ararobo/HTMDv2.2s/simpleBOM.xlsx

HTMDv2.2sBOM |  |  | 27623 |  |  | 単価(購入済み除く) | 2908.3
部品名 | 型番(定数) | 個数 |  | 単価 | 小計 | リンク | データシート | 1枚必要数 | 単価計算用
スイッチングレギュレータ | TPS628511DRLR | 10 | 個 | 177.5 | 1775 | TPS628511DRLR Texas Instruments | Mouser 日本 (https://www.mouser.jp/ProductDetail/Texas-Instruments/TPS628511DRLR?qs=QNEnbhJQKvbbsogrZa0o0A%3D%3D) | TPS62851x 2.7V～6V、0.5A/1A/2A/3A 降圧コンバータ、SOT583 パッケージ datasheet (Rev. B) (ti.com) (https://www.ti.com/jp/lit/ds/symlink/tps628511.pdf?ts=1696764551116) | 1 | 177.5
チップインダクタ | 0.47uH | 1 | パック(4個) | 100 | 100 | チップインダクター ０．４７μＨ３．３Ａ （４個入）: パーツ一般 秋月電子通商-電子部品・ネット通販 (akizukidenshi.com) (https://akizukidenshi.com/catalog/g/gP-15627/) |  | 1 | 25
抵抗 | 88.7k | 100 | 個 | 2 | 200 | CRCW060388K7FKEAC Vishay / Dale | Mouser 日本 (https://www.mouser.jp/ProductDetail/Vishay-Dale/CRCW060388K7FKEAC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) |  | 1
抵抗 | 19.6k | 100 | 個 | 1.4 | 140 | CRCW060319K6FKEAC Vishay / Dale | Mouser 日本 (https://www.mouser.jp/ProductDetail/Vishay-Dale/CRCW060319K6FKEAC) |  | 1
コンデンサ | 10p | 1000 | 個 | 1.8 | 1800 | KGM15ACG1H100JT KYOCERA AVX | Mouser 日本 (https://www.mouser.jp/ProductDetail/KYOCERA-AVX/KGM15ACG1H100JT) |  | 6
STM32G431CBU6 |  | 10 | 個 | 892 | 8920 | STM32G431CBU6 STMicroelectronics | Mouser 日本 (https://www.mouser.jp/ProductDetail/STMicroelectronics/STM32G431CBU6?qs=T3oQrply3y%252B0hTuSHQ7oqA%3D%3D) |  |  | 892
温度センサ | TMP275AQDGKRQ1 | 10 | 個 | 264 | 2640 | TMP275AQDGKRQ1 Texas Instruments | Mouser 日本 (https://www.mouser.jp/ProductDetail/Texas-Instruments/TMP275AQDGKRQ1?qs=8%2FmU9qzJpL%2FVpQiyN9hSdg%3D%3D) |  |  | 264
デジタルアイソレータ | ISO6741FDWR | 10 | 個 | 370.3 | 3703 | ISO6741FDWR Texas Instruments | Mouser 日本 (https://www.mouser.jp/ProductDetail/Texas-Instruments/ISO6741FDWR?qs=eP2BKZSCXI7%252BuWOGH5QbwQ%3D%3D) |  |  | 370.3
電流センサ | CZ3A05 | 10 | 個 | 789.5 | 7895 | https://www.mouser.jp/ProductDetail/Asahi-Kasei-Microdevices/CZ3A05?qs=vvQtp7zwQdOg3bf1lH9vOg%3D%3D |  |  | 789.5
精密抵抗 | 1kohm | 1 | パック(5個) | 100 | 100 | 超精密級 金属皮膜チップ抵抗器 １６０８ １／１０Ｗ１ｋΩ ±０．１％ （５個入）: パーツ一般 秋月電子通商-電子部品・ネット通販 (akizukidenshi.com) (https://akizukidenshi.com/catalog/g/gR-11790/) |  |  | 40
ADC | MCP3421A0T-E/CH | 1 | 個 | 350 | 350 | https://akizukidenshi.com/catalog/g/gI-16585/ |  |  | 350
 |  |  |  |  | 0
 |  |  |  |  | 0
 |  |  |  |  | 0
 |  |  |  |  | 0
 |  |  |  |  | 0
 |  |  |  |  | 0
 |  |  |  |  | 0
 |  |  |  |  | 0
 |  |  |  |  | 0
 |  |  |  |  | 0
