ararobo/HTMDv2.2s/HTMDv2.2s.kicad_pcb

## KiCad design HTMDv2.2s.kicad_pcb (2023-12-18)

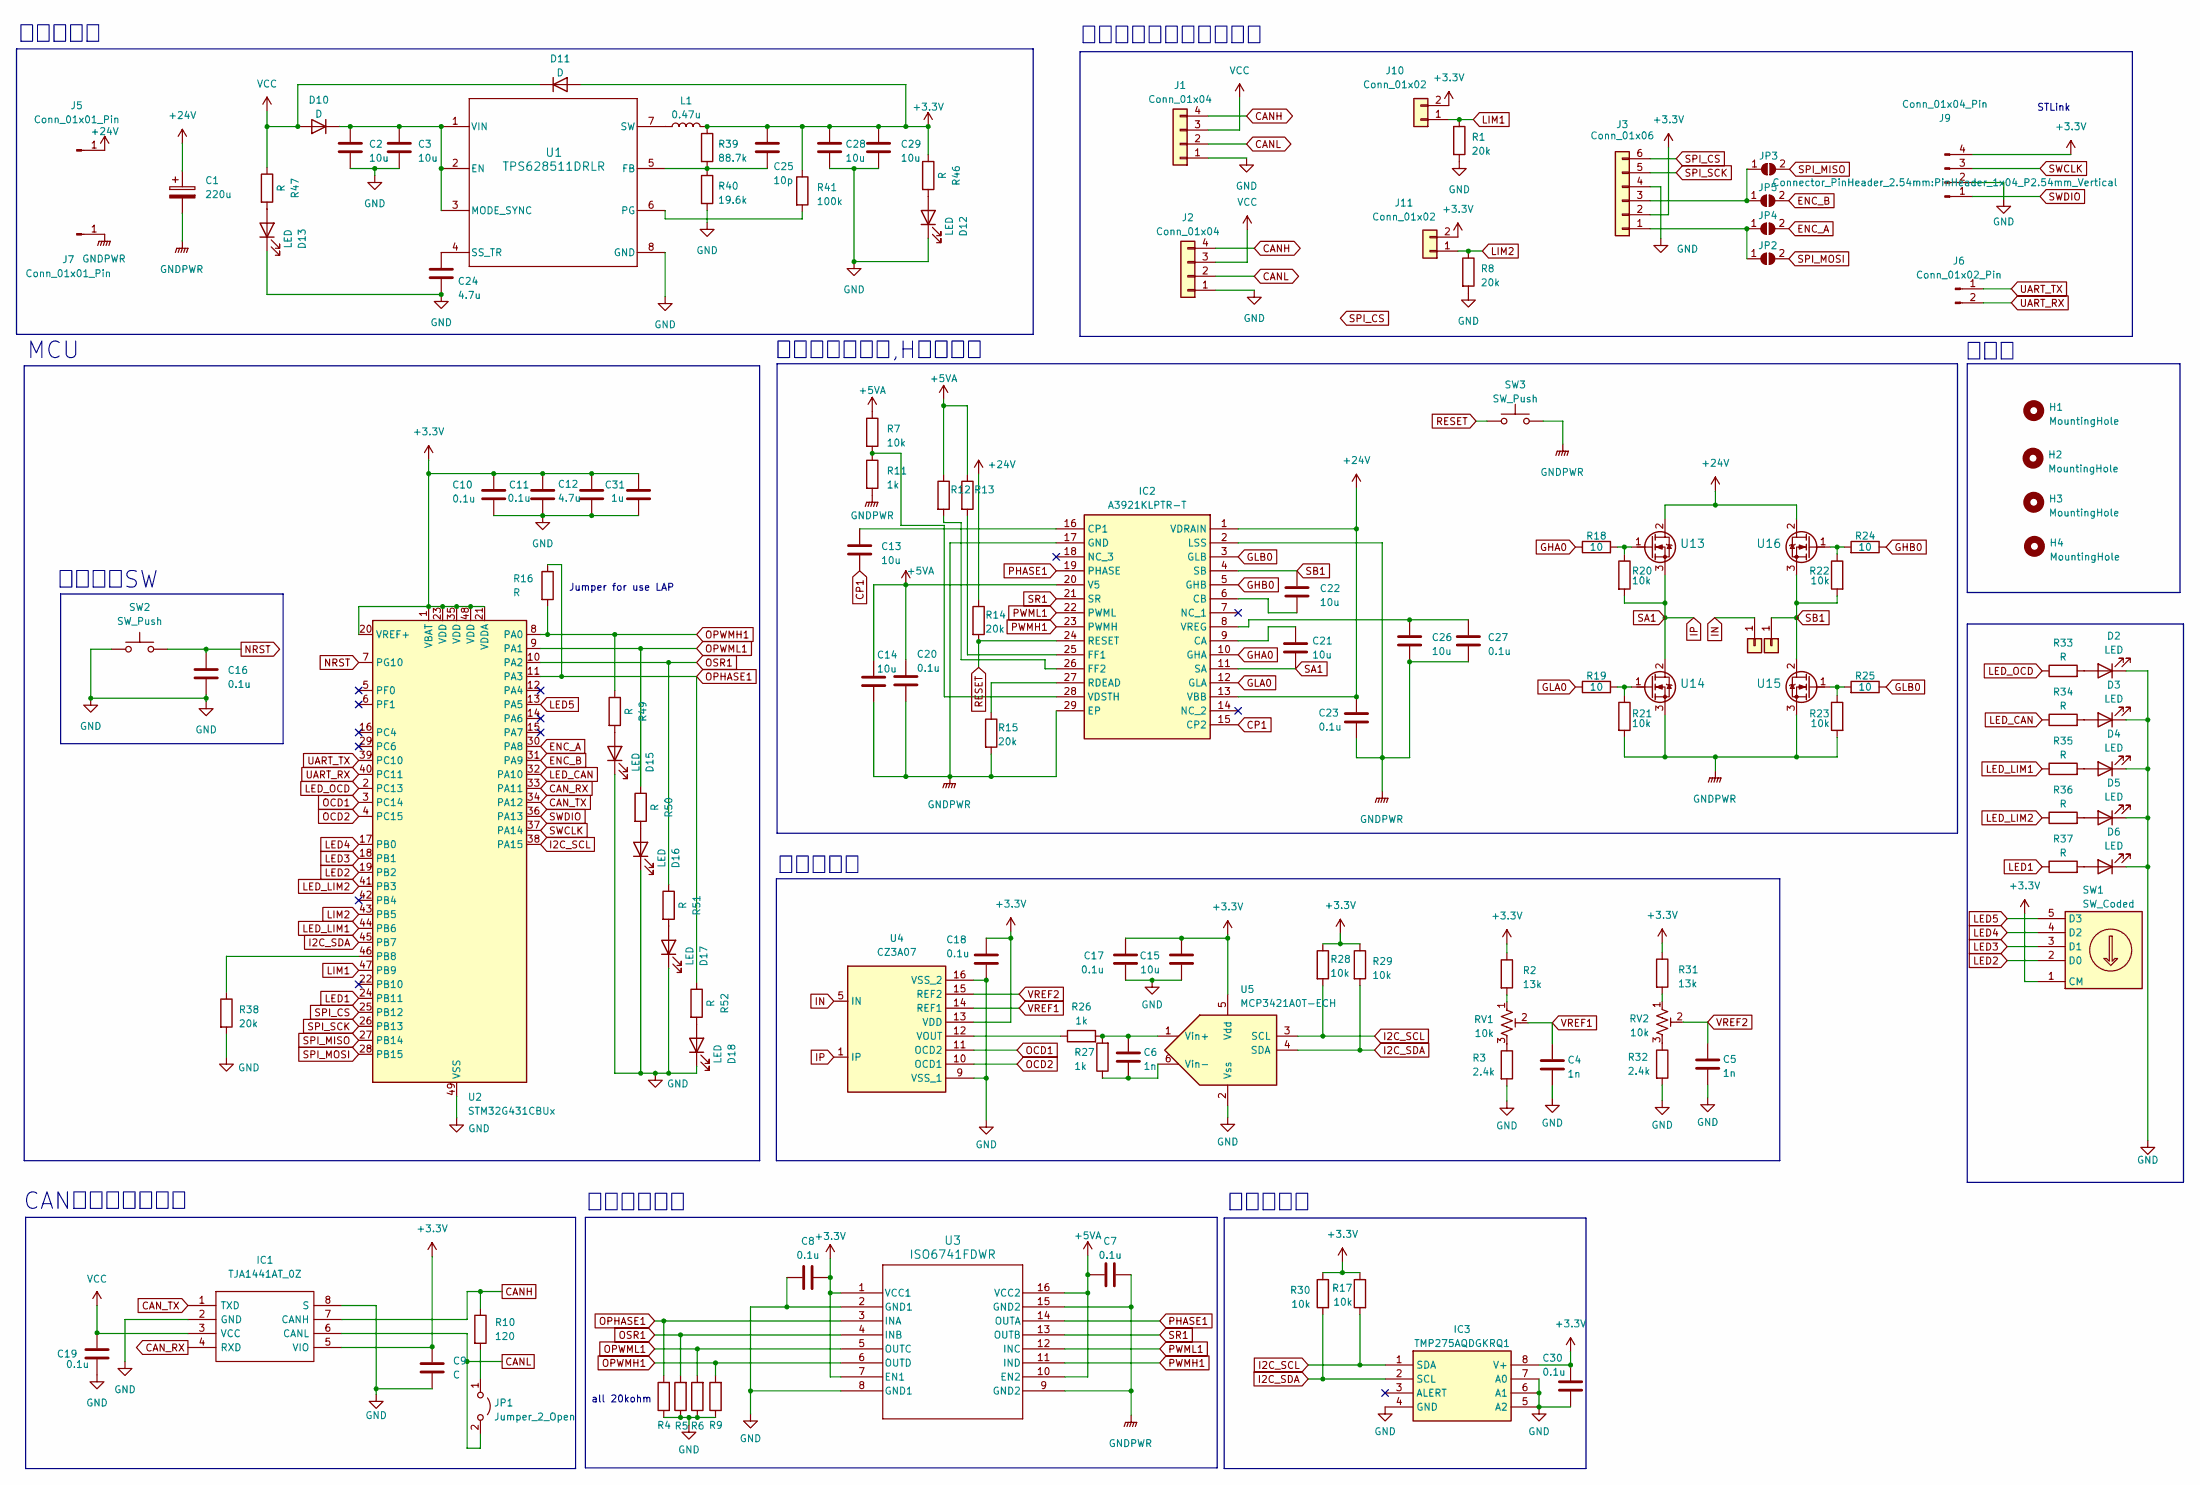
[picture p1: schematic HTMDv2.2s.kicad_sch]

Parts:
C1: 220u; CP_Radial_D10.0mm_P5.00mm
C2, C3, C13, C14, C15, C21, C22, C26, C28, C29: 10u; C_0805_2012Metric_Pad1.18x1.45mm_HandSolder
C4, C5, C6: 1n; C_0603_1608Metric_Pad1.08x0.95mm_HandSolder
C7, C8, C10, C11, C16, C17, C18, C19, C20, C23, C30: 0.1u; C_0603_1608Metric_Pad1.08x0.95mm_HandSolder
C9: C; C_0603_1608Metric_Pad1.08x0.95mm_HandSolder
C12, C24: 4.7u; C_0603_1608Metric_Pad1.08x0.95mm_HandSolder
C25: 10p; C_0603_1608Metric_Pad1.08x0.95mm_HandSolder
C27: 0.1u; C_0805_2012Metric_Pad1.18x1.45mm_HandSolder
C31: 1u; C_0603_1608Metric_Pad1.08x0.95mm_HandSolder
D2, D3, D4, D5, D6, D12, D13, D15, D16, D17, D18: LED; LED_0603_1608Metric_Pad1.05x0.95mm_HandSolder
D10, D11: D; SS2040FL
H1, H2, H3: MountingHole; MountingHole_3.2mm_M3
H4: MountingHole; MountingHole_3.2mm_M3_DIN965_Pad
IC1: TJA1441AT_0Z; SOIC127P600X175-8N; Mouser Part Number 771-TJA1441AT/0Z
IC2: A3921KLPTR-T; A3944KLPTRT; Manufacturer_Part_Number A3921KLPTR-T
IC3: TMP275AQDGKRQ1; Mouser Part Number 595-TMP275AQDGKRQ1
J1, J2: Conn_01x04; JST_XH_S4B-XH-A_1x04_P2.50mm_Horizontal
J3: Conn_01x06; JST_XH_S6B-XH-A_1x06_P2.50mm_Horizontal
J4, J8: Conn_01x01; ねじ端子(縦)
J5, J7: Conn_01x01_Pin; ねじ端子(縦)
J6: Conn_01x02_Pin; TestPoint_2Pads_Pitch2.54mm_Drill0.8mm
J9: Conn_01x04_Pin; PinHeader_1x04_P2.54mm_Vertical
J10, J11: Conn_01x02; JST_XH_S2B-XH-A_1x02_P2.50mm_Horizontal
JP1: Jumper_2_Open; TestPoint_2Pads_Pitch2.54mm_Drill0.8mm
JP2, JP3, JP4, JP5: SolderJumper_2_Open; R_0603_1608Metric_Pad0.98x0.95mm_HandSolder
L1: 0.47u; L_0603_1608Metric_Pad1.05x0.95mm_HandSolder
R1, R8, R12, R13, R14, R15, R38: 20k; R_0603_1608Metric_Pad0.98x0.95mm_HandSolder
R2, R31: 13k; R_0603_1608Metric_Pad0.98x0.95mm_HandSolder
R3, R32: 2.4k; R_0603_1608Metric_Pad0.98x0.95mm_HandSolder
R4, R5, R6, R9, R16, R33, R34, R35, R36, R37, R46, R47, R49, R50, R51, R52: R; R_0603_1608Metric_Pad0.98x0.95mm_HandSolder
R7, R17, R28, R29, R30: 10k; R_0603_1608Metric_Pad0.98x0.95mm_HandSolder
R10: 120; R_0603_1608Metric
R11, R26, R27: 1k; R_0603_1608Metric_Pad0.98x0.95mm_HandSolder
R18, R19, R24, R25: 10; R_0603_1608Metric
R20, R21, R22, R23: 10k; R_0603_1608Metric
R39: 88.7k; R_0603_1608Metric_Pad0.98x0.95mm_HandSolder
R40: 19.6k; R_0603_1608Metric_Pad0.98x0.95mm_HandSolder
R41: 100k; L_0603_1608Metric_Pad1.05x0.95mm_HandSolder
RV1, RV2: 10k; TSR-3296
SW1: SW_Coded; FR01FR16H-S
SW2, SW3: SW_Push; TVAF06
U1: TPS628511DRLR; DRL0008A-MFG
U2: STM32G431CBUx; QFN-48-1EP_7x7mm_P0.5mm_EP5.6x5.6mm
U3: ISO6741FDWR; ISO674x
U4: CZ3A07; CZ3AG6; Mouser Part Number 412-CZ3A07
U5: MCP3421A0T-ECH; SOT-23-6_Handsoldering
U13, U14, U15, U16: SQJ180EP-T1_GE3; PowerPAK_SO-8_Single

Connections:
+3.3V: C8.2, C9.1, C10.1, C11.1, C12.1, C15.1, C17.1, C18.1, C25.1, C28.1, C29.1, C30.1, C31.1, D11.2 (A), IC1.5 (VIO), IC3.8 (V+), J3.2, J9.4, J10.2, J11.2, L1.2, R2.1, R17.1, R28.1, R29.1, R30.1, R31.1, R39.1, R41.1, R46.1, SW1.1 (CM), U2.1 (VBAT), U2.20 (VREF+), U2.21 (VDDA), U2.23 (VDD), U2.35 (VDD), U2.48 (VDD), U3.1 (VCC1), U3.7 (EN1), U4.13 (VDD), U5.5 (Vdd)
+5VA: C7.1, C14.1, C20.1, IC2.20 (V5), R7.1, R12.1, R13.1, U3.10 (EN2), U3.16 (VCC2)
+24V: C1.1, C23.1, IC2.1 (VDRAIN), IC2.13 (VBB), J5.1, R14.1, U13.2, U16.2
CANH: IC1.7 (CANH), J1.4, J2.4, R10.1
CANL: IC1.6 (CANL), J1.2, J2.2, JP1.2 (B)
CAN_RX: IC1.4 (RXD), U2.33 (PA11)
CAN_TX: IC1.1 (TXD), U2.34 (PA12)
CP1: C13.2, IC2.15 (CP2)
ENC_A: JP4.2 (B), U2.30 (PA8)
ENC_B: JP5.2 (B), U2.31 (PA9)
GHA0: IC2.10 (GHA), R18.1
GHB0: IC2.5 (GHB), R24.1
GLA0: IC2.12 (GLA), R19.1
GLB0: IC2.3 (GLB), R25.1
GND: C2.2, C3.2, C4.2, C5.2, C8.1, C9.2, C10.2, C11.2, C12.2, C15.2, C16.2, C17.2, C18.2, C19.2, C24.2, C28.2, C29.2, C30.2, C31.2, D2.1 (K), D3.1 (K), D4.1 (K), D5.1 (K), D6.1 (K), D12.1 (K), D13.1 (K), D15.1 (K), D16.1 (K), D17.1 (K), D18.1 (K), H4.1, IC1.2 (GND), IC1.8 (S), IC3.4 (GND), IC3.5 (A2), IC3.6 (A1), IC3.7 (A0), J1.1, J2.1, J3.4, J9.2, R1.2, R3.2, R4.1, R5.1, R6.1, R8.2, R9.1, R32.2, R38.2, R40.2, SW2.1, U1.8 (GND), U2.49 (VSS), U3.2 (GND1), U3.8 (GND1), U4.9 (VSS_1), U4.16 (VSS_2), U5.2 (Vss)
GNDPWR: C1.2, C7.2, C14.2, C20.2, C23.2, C26.2, C27.2, IC2.2 (LSS), IC2.17 (GND), IC2.29 (EP), J7.1, R11.2, R15.2, R21.2, R23.2, SW3.1, U3.9 (GND2), U3.15 (GND2), U14.3, U15.3
I2C_SCL: IC3.1 (SDA), R17.2, R28.2, U2.38 (PA15), U5.3 (SCL)
I2C_SDA: IC3.2 (SCL), R29.2, R30.2, U2.45 (PB7), U5.4 (SDA)
IN: J4.1, U4.5 (IN)
IP: C21.2, IC2.11 (SA), R20.2, U4.1 (IP), U13.3, U14.2
LED1: R37.1, U2.24 (PB11)
LED2: SW1.2 (D0), U2.19 (PB2)
LED3: SW1.3 (D1), U2.18 (PB1)
LED4: SW1.4 (D2), U2.17 (PB0)
LED5: SW1.5 (D3), U2.13 (PA5)
LED_CAN: R34.1, U2.32 (PA10)
LED_LIM1: R35.1, U2.44 (PB6)
LED_LIM2: R36.1, U2.41 (PB3)
LED_OCD: R33.1, U2.2 (PC13)
LIM1: J10.1, R1.1, U2.47 (PB9)
LIM2: J11.1, R8.1, U2.43 (PB5)
NRST: C16.1, SW2.2, U2.7 (PG10)
unnamed: D2.2 (A), R33.2
unnamed: D3.2 (A), R34.2
unnamed: D4.2 (A), R35.2
unnamed: D5.2 (A), R36.2
unnamed: D6.2 (A), R37.2
unnamed: C2.1, C3.1, D10.1 (K), U1.1 (VIN), U1.2 (EN), U1.3 (MODE_SYNC)
unnamed: D12.2 (A), R46.2
unnamed: D13.2 (A), R47.2
unnamed: D15.2 (A), R49.2
unnamed: D16.2 (A), R50.2
unnamed: D17.2 (A), R51.2
unnamed: D18.2 (A), R52.2
unnamed: C21.1, IC2.9 (CA)
unnamed: C22.2, IC2.6 (CB)
unnamed: C13.1, IC2.16 (CP1)
unnamed: IC2.25 (FF1), R13.2
unnamed: IC2.26 (FF2), R12.2
unnamed: IC2.27 (RDEAD), R15.1
unnamed: IC2.28 (VDSTH), R7.2, R11.1
unnamed: C26.1, C27.1, IC2.8 (VREG)
unnamed: J3.1, JP2.1 (A), JP4.1 (A)
unnamed: J3.3, JP3.1 (A), JP5.1 (A)
unnamed: JP1.1 (A), R10.2
unnamed: R2.2, RV1.1
unnamed: R3.1, RV1.3
unnamed: R18.2, R20.1, U13.1
unnamed: R19.2, R21.1, U14.1
unnamed: R22.1, R24.2, U16.1
unnamed: R23.1, R25.2, U15.1
unnamed: R31.2, RV2.1
unnamed: R32.1, RV2.3
unnamed: C25.2, R39.2, R40.1, U1.5 (FB)
unnamed: R41.2, U1.6 (PG)
unnamed: C24.1, U1.4 (SS_TR)
unnamed: L1.1, U1.7 (SW)
unnamed: R38.1, U2.46 (PB8)
unnamed: R26.1, U4.12 (VOUT)
unnamed: C6.1, R26.2, R27.2, U5.1 (Vin+)
unnamed: C6.2, R27.1, U5.6 (Vin-)
OCD1: U2.3 (PC14), U4.11 (OCD2)
OCD2: U2.4 (PC15), U4.10 (OCD1)
OPHASE1: R4.2, R16.1, R52.1, U2.11 (PA3), U3.3 (INA)
OPWMH1: R9.2, R16.2, R49.1, U2.8 (PA0), U3.6 (OUTD)
OPWML1: R6.2, R50.1, U2.9 (PA1), U3.5 (OUTC)
OSR1: R5.2, R51.1, U2.10 (PA2), U3.4 (INB)
PHASE1: IC2.19 (PHASE), U3.14 (OUTA)
PWMH1: IC2.23 (PWMH), U3.11 (IND)
PWML1: IC2.22 (PWML), U3.12 (INC)
RESET: IC2.24 (RESET), R14.2, SW3.2
SB1: C22.1, IC2.4 (SB), J8.1, R22.2, U15.2, U16.3
SPI_CS: J3.6, U2.25 (PB12)
SPI_MISO: JP3.2 (B), U2.27 (PB14)
SPI_MOSI: JP2.2 (B), U2.28 (PB15)
SPI_SCK: J3.5, U2.26 (PB13)
SR1: IC2.21 (SR), U3.13 (OUTB)
SWCLK: J9.3, U2.37 (PA14)
SWDIO: J9.1, U2.36 (PA13)
UART_RX: J6.2, U2.40 (PC11)
UART_TX: J6.1, U2.39 (PC10)
VCC: C19.1, D10.2 (A), D11.1 (K), IC1.3 (VCC), J1.3, J2.3, R47.1
VREF1: C4.1, RV1.2, U4.14 (REF1)
VREF2: C5.1, RV2.2, U4.15 (REF2)

Notes on the sheet:
MCU
電源ライン
ゲートドライバ,Hブリッジ
all 20kohm
通信用インターフェース
STLink
Jumper for use LAP
リセットSW
電流センサ
温度センサ
ホール
アイソレータ
CANトランシーバー

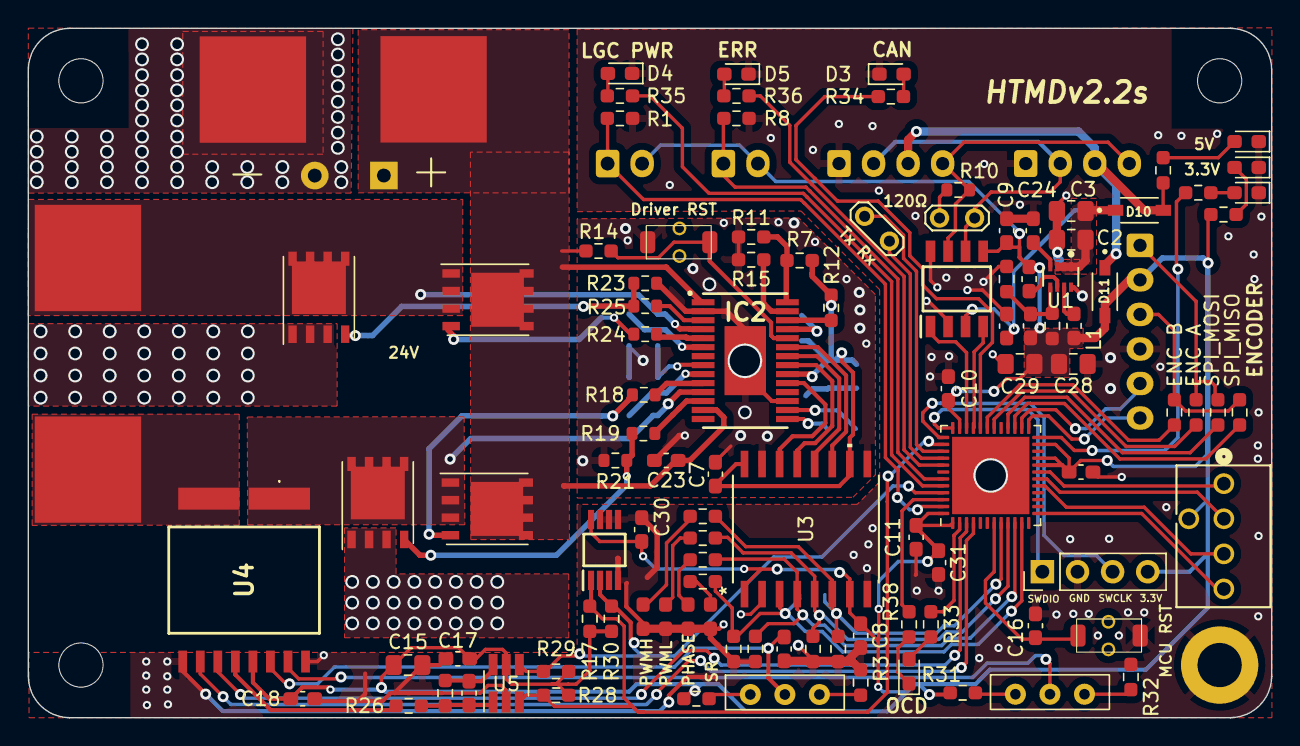
[picture p2: board HTMDv2.2s.kicad_pcb from above]

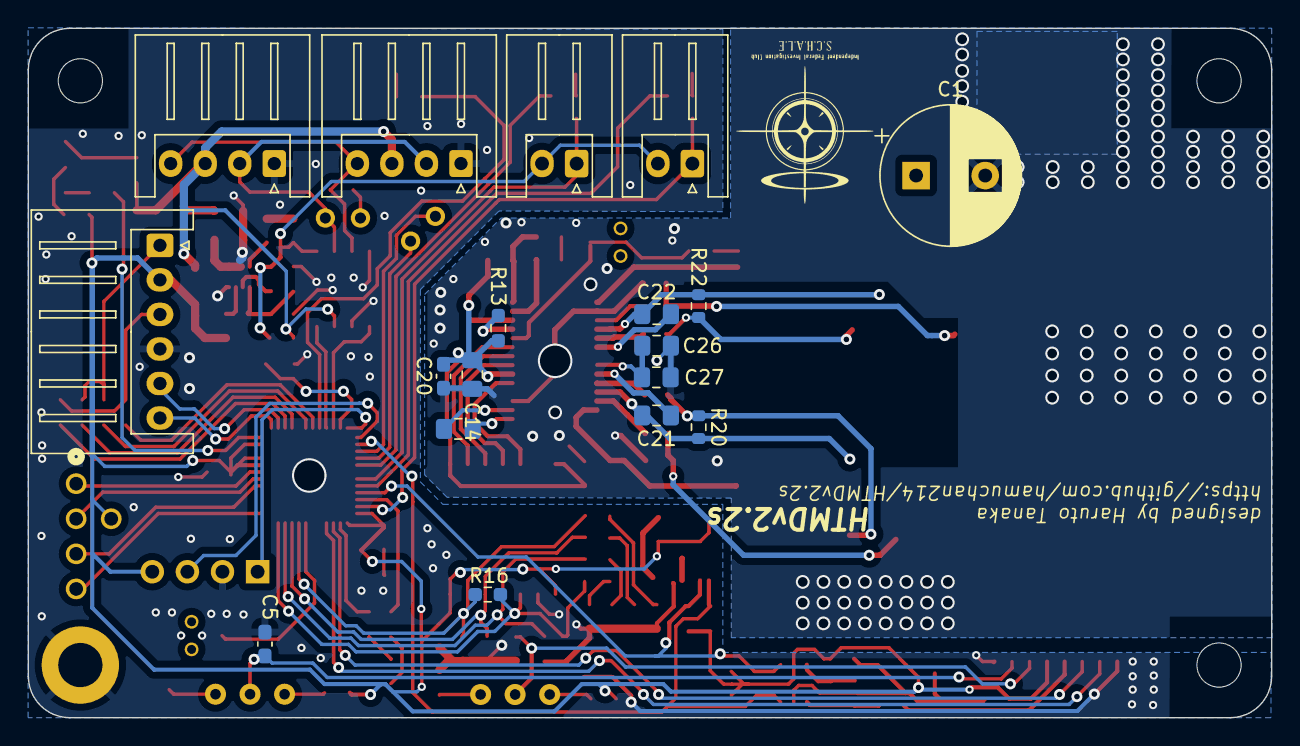
[picture p3: board HTMDv2.2s.kicad_pcb from below]

Board: 4 copper layers, 90.0 x 49.9 mm, 129 parts (18 on the bottom side), 94 nets.
