ararobo/HTMDv2.2s/HTMDv2.2sg431/Core/Src/main.cpp

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
/* Includes ------------------------------------------------------------------*/
#include "main.h"
#include "dma.h"
#include "fdcan.h"
#include "i2c.h"
#include "spi.h"
#include "tim.h"
#include "usart.h"
#include "gpio.h"

/* USER CODE BEGIN Includes */
#include "CANManager.hpp"
/* USER CODE END Includes */


void SystemClock_Config(void);
/**
  * @brief  The application entry point.
  * @retval int
  */
int main(void)
{
  /* USER CODE BEGIN 1 */
  CANManager CAN;
  /* USER CODE END 1 */

  /* MCU Configuration--------------------------------------------------------*/

  /* Reset of all peripherals, Initializes the Flash interface and the Systick. */
  HAL_Init();

  /* Configure the system clock */
  SystemClock_Config();

  /* Initialize all configured peripherals */
  MX_GPIO_Init();
  MX_DMA_Init();
  MX_FDCAN1_Init();
  MX_I2C1_Init();
  MX_TIM1_Init();
  MX_TIM2_Init();
  MX_USART3_UART_Init();
  MX_SPI2_Init();
  MX_TIM3_Init();
  MX_TIM4_Init();
  /* USER CODE BEGIN 2 */
  HAL_GPIO_WritePin(LED1_GPIO_Port,LED1_Pin,GPIO_PIN_SET);
  CAN.CAN_FilterSetup();
  CAN.CAN_Start();
  while (CAN.Is_init == false)
  {
    ;
  }
  HAL_GPIO_WritePin(LED_CAN_GPIO_Port,LED_CAN_Pin,GPIO_PIN_SET);
  /* USER CODE END 2 */

  /* Infinite loop */
  /* USER CODE BEGIN WHILE */
  while (1)
  {
    /* USER CODE END WHILE */
    HAL_GPIO_TogglePin(LED1_GPIO_Port,LED1_Pin);
    HAL_Delay(500);
    /* USER CODE BEGIN 3 */
  }
  /* USER CODE END 3 */
}

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
