ararobo/HTMDv2.2s/HTMDv2.2sg431/HTMDv2.2sg431.ioc

Mcu.UserName=STM32G431CBUx
PA0.Signal=S_TIM2_CH1
PA1.GPIO_Label=PWM_L
PA1.Signal=GPIO_Output
PA10.GPIO_Label=LED_CAN
PA10.Signal=GPIO_Output
PA11.Signal=FDCAN1_RX
PA12.Signal=FDCAN1_TX
PA13.Signal=SYS_JTMS-SWDIO
PA14.Signal=SYS_JTCK-SWCLK
PA15.Signal=I2C1_SCL
PA2.GPIO_Label=PHASE
PA2.Signal=GPIO_Output
PA3.GPIO_Label=SR
PA3.Signal=GPIO_Output
PA4.GPIO_Label=SPI1_CS
PA4.Signal=GPIO_Output
PA5.GPIO_Label=LED6
PA5.Signal=GPIO_Output
PA6.Signal=S_TIM3_CH1
PA7.Signal=S_TIM3_CH2
PA8.Signal=S_TIM1_CH1
PA9.Signal=S_TIM1_CH2
PB0.GPIO_Label=LED4
PB0.Signal=GPIO_Output
PB1.GPIO_Label=LED3
PB1.Signal=GPIO_Output
PB11.GPIO_Label=LED1
PB11.Signal=GPIO_Output
PB12.GPIO_Label=SPI2_CS
PB12.Signal=GPIO_Output
PB13.Signal=SPI2_SCK
PB14.Signal=SPI2_MISO
PB15.Signal=SPI2_MOSI
PB2.GPIO_Label=LED2
PB2.Signal=GPIO_Output
PB3.GPIO_Label=DIP2
PB3.Signal=GPIO_Input
PB4.GPIO_Label=DPI3
PB4.Signal=GPIO_Input
PB5.GPIO_Label=DPI4
PB5.Signal=GPIO_Input
PB6.GPIO_Label=LED_lim1
PB6.Signal=GPIO_Output
PB7.Signal=I2C1_SDA
PB9.GPIO_Label=LIM1
PB9.Signal=GPIO_Input
PC10.Signal=USART3_TX
PC11.Signal=USART3_RX
PC13.GPIO_Label=DIP1
PC13.Signal=GPIO_Input
PC14-OSC32_IN.GPIO_Label=OCD1
PC14-OSC32_IN.Signal=GPIO_Input
PC15-OSC32_OUT.GPIO_Label=OCD2
PC15-OSC32_OUT.Signal=GPIO_Input
PC4.GPIO_Label=LED5
PC4.Signal=GPIO_Output
