ararobo/HTMDv2.2s/(commit log)

2023-10-02 init commit
    [HTMDv2.1.kicad_pcb, HTMDv2.1.kicad_sch]
2023-10-05 update PCB
    [HTMDv2.2s.kicad_pcb, HTMDv2.2s.kicad_sch]
2023-10-07 update
    配線作業ちう
    [HTMDv2.2s.kicad_pcb]
2023-10-07 update
    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
    [HTMDv2.2s.kicad_pcb]
2023-10-07 Update HTMDv2.2s.kicad_sch
    add LEDs
    [HTMDv2.2s.kicad_sch]
2023-10-07 update
    change footprints
    [HTMDv2.2s.kicad_pcb, HTMDv2.2s.kicad_sch]
2023-10-07 Update HTMDv2.2sg431.ioc
    pin changed
2023-10-07 update
    add power line
    [HTMDv2.2s.kicad_pcb, HTMDv2.2s.kicad_sch]
2023-10-07 update
    SYS配線の見直し
    [HTMDv2.2s.kicad_pcb, HTMDv2.2s.kicad_sch]
2023-10-07 pre cmpl
    レビューまち
    [HTMDv2.2s.kicad_pcb, HTMDv2.2s.kicad_sch]
2023-10-07 update
    change 3D models
    [HTMDv2.2s.kicad_pcb]
2023-10-08 update
    温度センサ周りの配線
    プルダウン抵抗の位置変更
    ドライブラインのLED追加
    [HTMDv2.2s.kicad_pcb, HTMDv2.2s.kicad_sch]
2023-10-08 Update HTMDv2.2s.kicad_pcb
    配線の微調整
    [HTMDv2.2s.kicad_pcb]
2023-10-08 Update HTMDv2.2s.kicad_pcb
    ねじ端子直下にビアを追加
    [HTMDv2.2s.kicad_pcb]
2023-10-08 update
    ティアドロップの追加
    DRCの解消
    [HTMDv2.2s.kicad_pcb]
2023-10-08 Update HTMDv2.2s.kicad_pcb
    パッド内の配線を削除
    重複した配線のマージ
    未配線ビア(GND除く)の削除
    [HTMDv2.2s.kicad_pcb]
2023-10-08 update
    ノイズ対策を追加
    [HTMDv2.2s.kicad_pcb]
2023-10-08 update
    導体スライパーの解決
    [HTMDv2.2s.kicad_pcb]
2023-10-08 Update HTMDv2.2s.kicad_pcb
    シルクの再配置
    ティアドロップの修正
    [HTMDv2.2s.kicad_pcb]
2023-10-08 update
    配線の修正
    [HTMDv2.2s.kicad_pcb, HTMDv2.2s.kicad_sch]
2023-10-08 Update HTMDv2.2s.kicad_sch
    回路定数が間違っていたのを修正
    [HTMDv2.2s.kicad_sch]
2023-10-08 update
    発注Done
    [HTMDv2.2s.kicad_pcb, HTMDv2.2s.kicad_sch, bom.csv, designators.csv, positions.csv]
2023-10-08 Create simpleBOM.xlsx
    BOMの追加
    [simpleBOM.xlsx]
2023-10-10 generated HW
    stm32プロジェクト生成した
2023-10-10 change Makefile
    makefileの変更
    mainファイルをcからcppに変更
2023-10-11 update
    A3921Driverをcppからhppに変更
2023-10-11 update
    整えた
2023-10-11 update
    CANManagerの作成
    PWMHのピンラベルを削除
2023-10-11 update
    CANマネージャの更新
2023-10-11 Update CANManager.cpp
    送受信関数の追加
2023-10-12 フォルダ整理
    App/Tasksを追加
    moduleディレクトリを追加
2023-10-12 CANManagerのクラス化
2023-10-12 PIDの空プログラムを追加
2023-10-12 CANManagerの分割
2023-10-12 A3921Driverインスタンスの生成場所を決めた
2023-10-12 A3921のインスタンスを指定した
2023-10-17 MCP3421ライブラリを書き始めた
2023-10-21 回路の修正
    [HTMDv2.2s.kicad_pcb, HTMDv2.2s.kicad_sch]
2023-10-21 ガーバー
    [HTMDv2.2s.kicad_pcb, bom.csv, designators.csv, positions.csv]
