ararobo/HTMDv2.2s/(notices)

Notices in the files:
HTMDv2.2sg431/Core/Src/main.cpp:
Copyright (c) 2023 STMicroelectronics.
All rights reserved.
This software is licensed under terms that can be found in the LICENSE file
